MDAlamin13/Trafic-Estimator/GccApplication4/GccApplication4/GccApplication4.c

#include <avr/io.h>
#define F_CPU 1000000
#include <util/delay.h>

int count1;
int count2;
int count3;
int count4;
int count5;
int count6;
int count7;
int count0;

int present0;
int present1;
int present2;
int present3;
int present4;
int present5;
int present6;
int present7;

int roadCount1;
int roadCount2;
int roadCount3;
int roadCount4;

uint16_t volt0;
uint16_t volt1;
uint16_t volt2;
uint16_t volt3;
uint16_t volt4;
uint16_t volt5;
uint16_t volt6;
uint16_t volt7;

void InitADC()
{
	ADMUX=(1<<REFS0);                         // For Aref=AVcc;
	ADCSRA=(1<<ADEN)|(1<<ADPS2)|(1<<ADPS1)|(1<<ADPS0); //Rrescalar div factor =128
}

uint16_t ReadADC(uint8_t ch)
{
	//Select ADC Channel ch must be 0-7
	ch=ch&0b00000111;
	ADMUX|=ch;

	//Start Single conversion
	ADCSRA|=(1<<ADSC);

	//Wait for conversion to complete
	while(!(ADCSRA & (1<<ADIF)));

	//Clear ADIF by writing one to it
	//Note you may be wondering why we have write one to clear it
	//This is standard way of clearing bits in io as said in datasheets.
	//The code writes '1' but it result in setting bit to '0' !!!

	ADCSRA|=(1<<ADIF);

	return(ADC);
}

int main(void)
{
	DDRD = 0xFF;
	DDRC = 0xFF;
	uint16_t adc_result0;
	uint16_t adc_result1;
	uint16_t adc_result2;
	uint16_t adc_result3;
	uint16_t adc_result4;
	uint16_t adc_result5;
	uint16_t adc_result6;
	uint16_t adc_result7;
	
	InitADC();
	present7=present6=present5=present4=present3=present2=present1=present0=0;
	

	count0=count1=count2=count3=count4=count5=count6=count7=0;
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
		else if(roadCount2>=roadCount1 && roadCount2>=roadCount3 && roadCount2>=roadCount4) PORTD=0b10100110;
		else if((roadCount3>=roadCount2 && roadCount3>=roadCount1 && roadCount3>=roadCount4)) PORTD=0b10011010;
		else PORTD=0b01101010;
	}
}
